masonbrainard/travel_cribbage/tc_v1_2p_gb.jpg

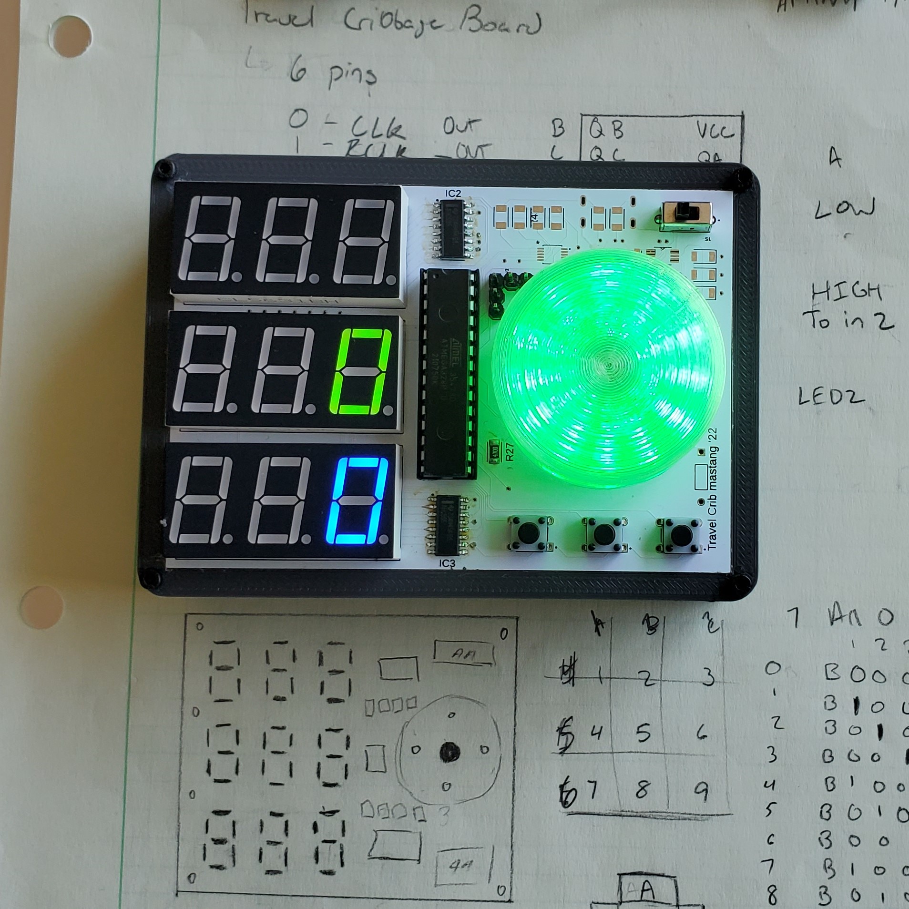
tc_v1_2p_gb.jpg
