masonbrainard/travel_cribbage/tc_v1_2p_rb.jpg

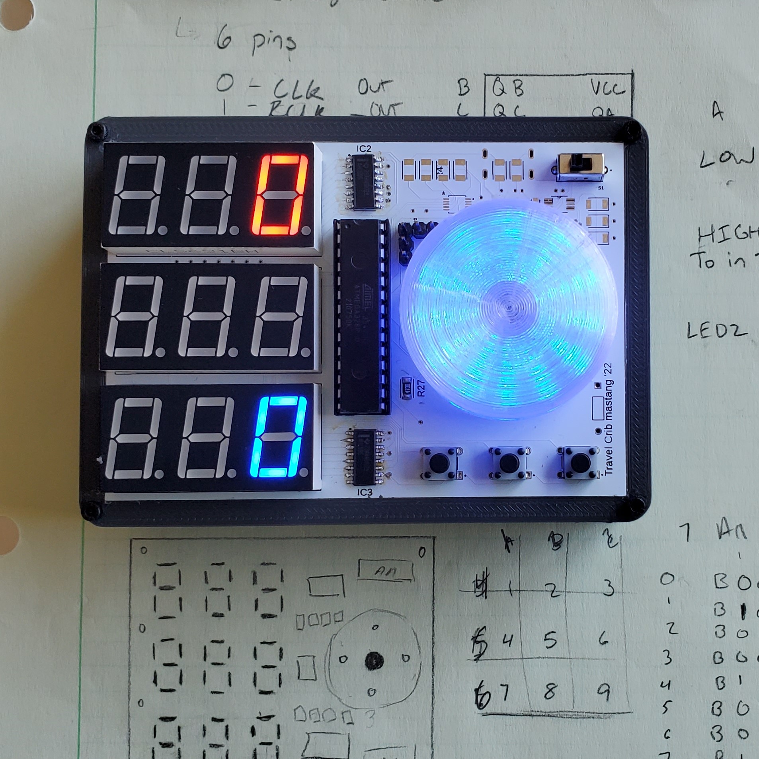
tc_v1_2p_rb.jpg
