masonbrainard/travel_cribbage/tc_v1_board_back.jpg

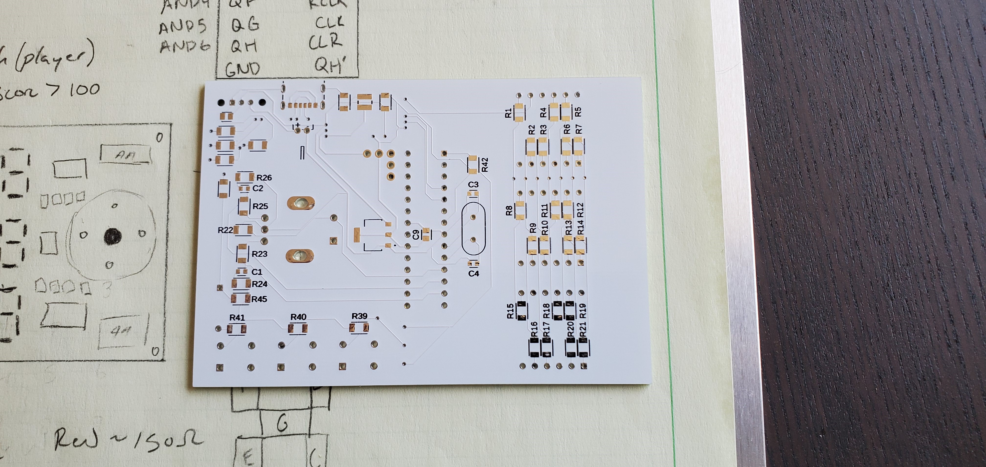
tc_v1_board_back.jpg
