masonbrainard/travel_cribbage/tc_v1_off.jpg

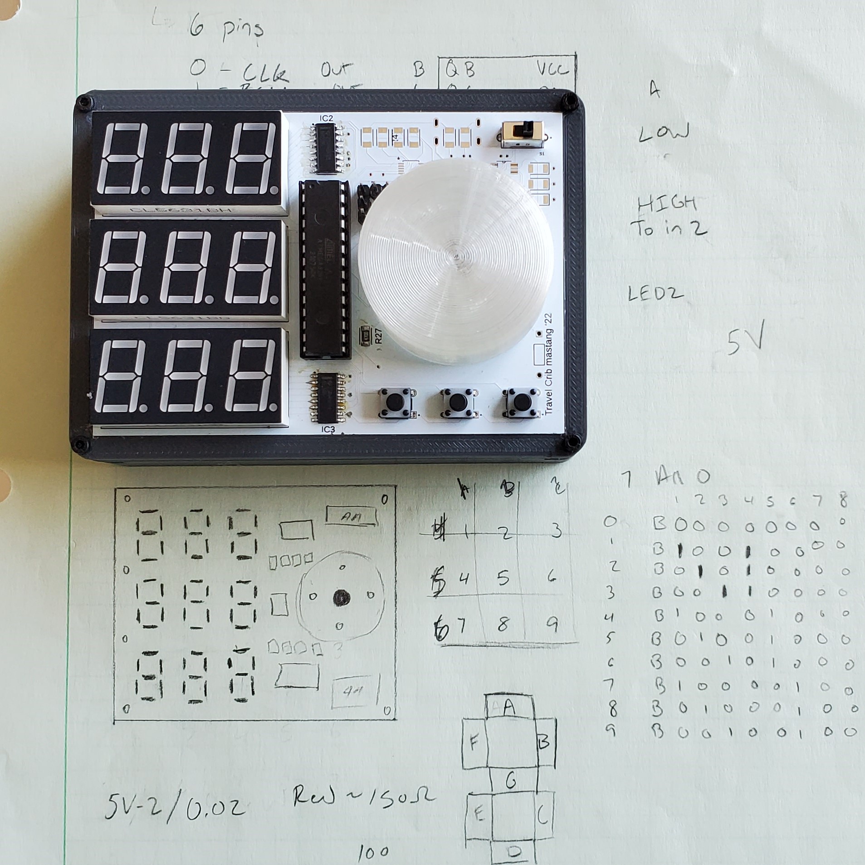
tc_v1_off.jpg
