masonbrainard/travel_cribbage/tv_v1_board_front.jpg

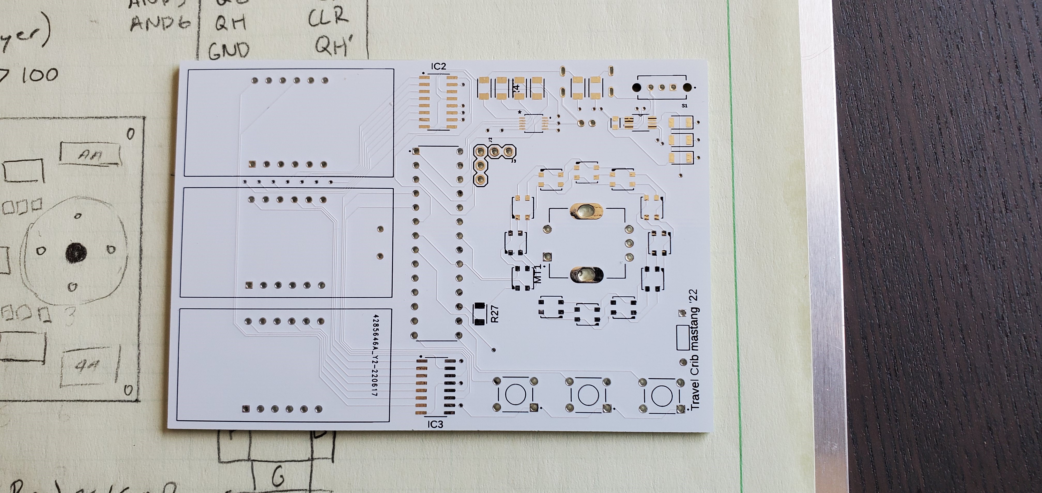
tv_v1_board_front.jpg
