masonbrainard/travel_cribbage/travelcribbage_schematic.pdf

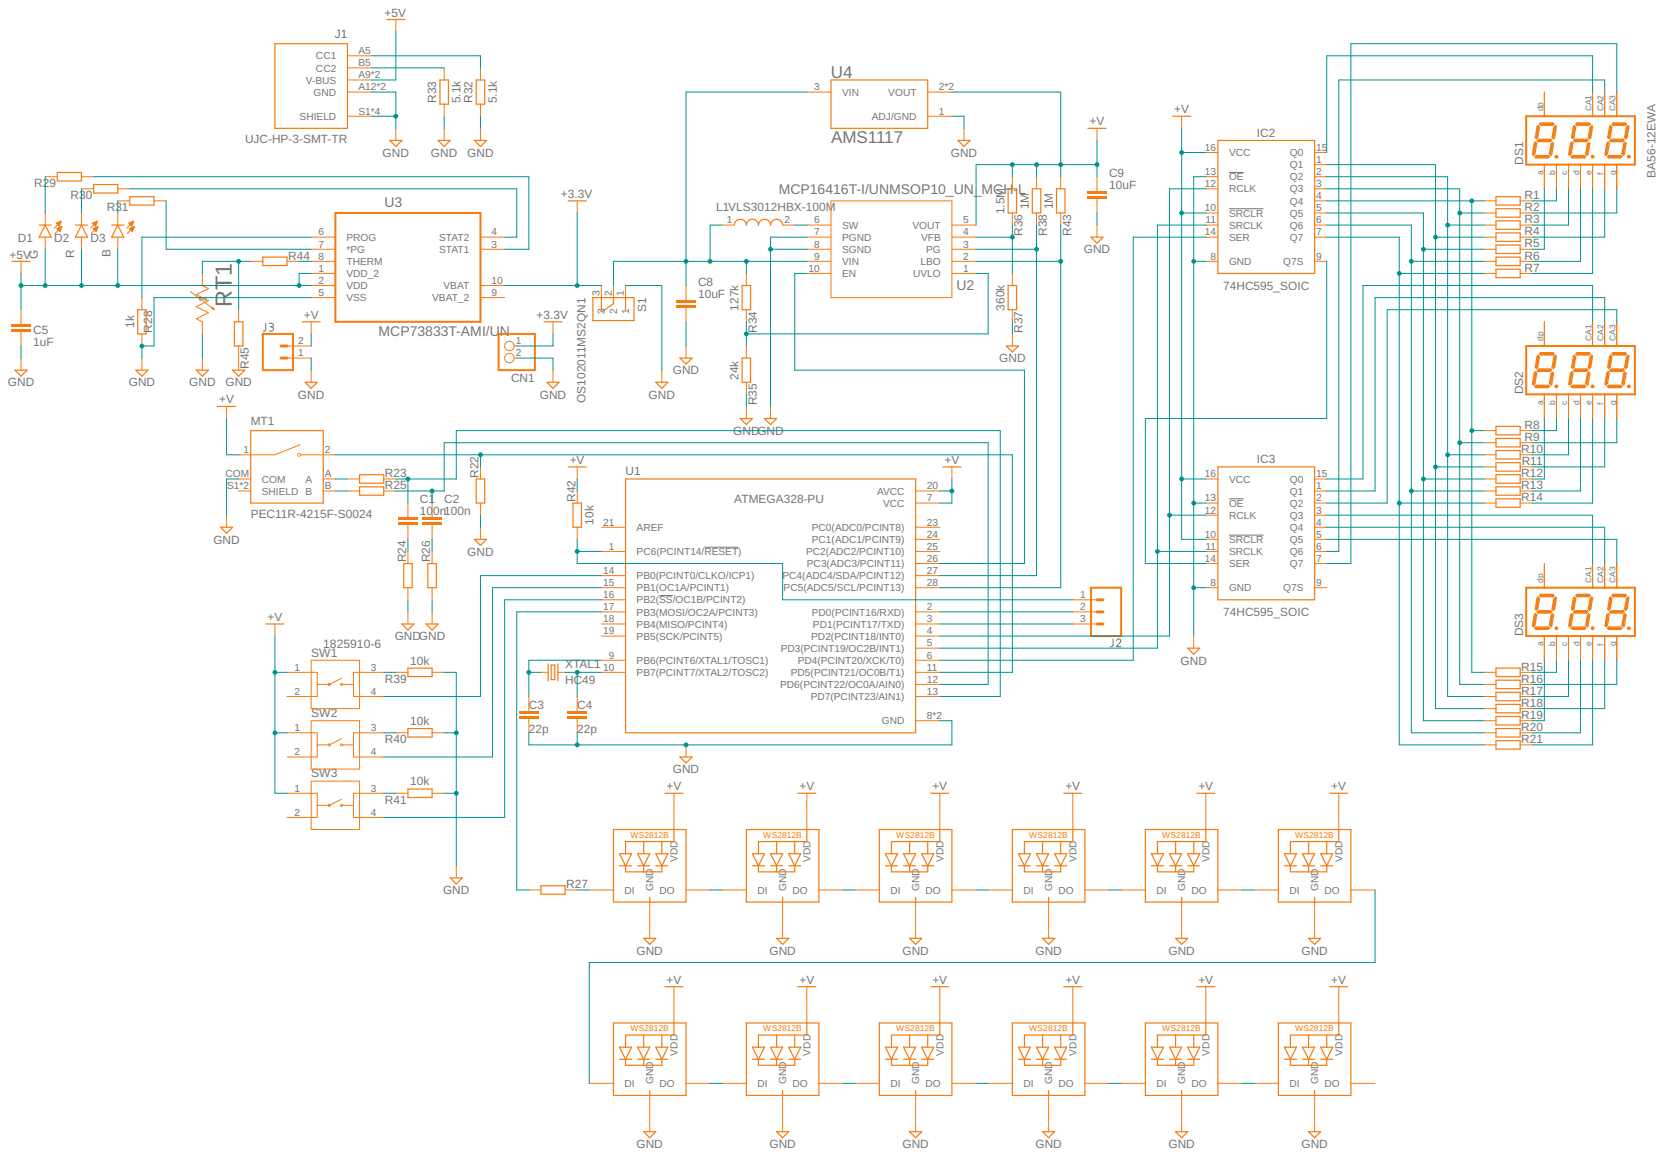
[picture p7: page 1]

UJC-HP-3-SMT-TR
