masonbrainard/travel_cribbage/travelcribbage_layout.pdf

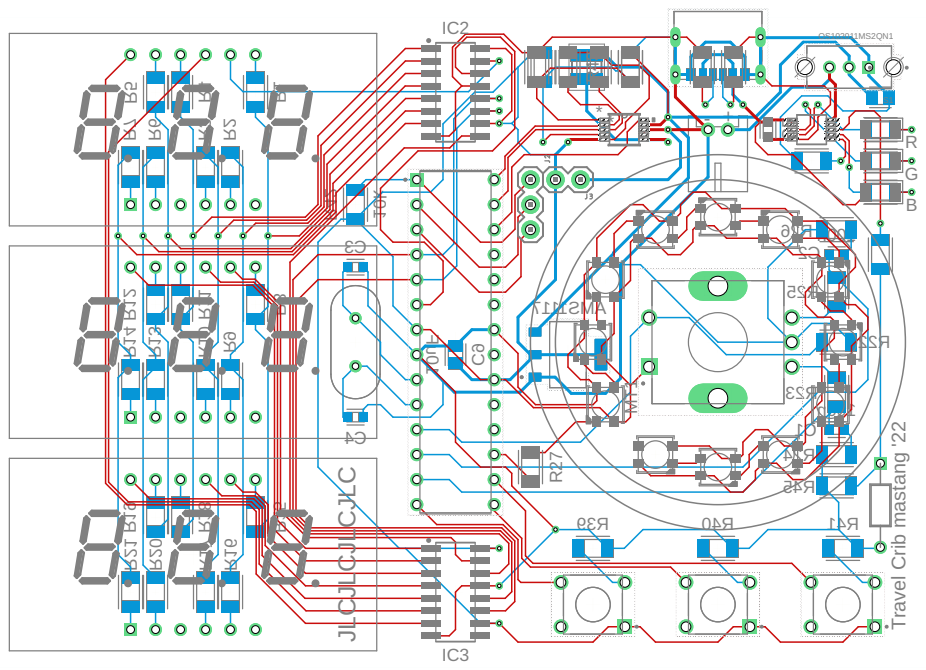
[picture p8: page 1]

n001 n001 10k 10uF 7111S MA R1 R10 R11 R12 R13 R14 R15 R16 R17 R18 R19 R20 R21 R8 R922 R 1 C2 C 32 R 42 R 52 R 62 R R2 R3 R4 R5 R6 R7 93 R 04 R 14 R 3 C4 C R42 C9 54 R * * - + JLCJLCJLCJLC Travel Crib mastang '22 IC2 IC3 MT1 R27 C5 R43 S1 GRB OS102011MS2QN1
