masonbrainard/travel_cribbage/(commit log)

2022-07-11 improved undo button
2022-07-12 fixed direction of dial leds when turning
    [tc.ino]
